LeoPezzini/nexo-midi-controller-Compl-Analog-II/docs/hardware/arquitectura.md

# Arquitectura del sistema

## Descripcion general

Nexo MIDI separa la adquisicion de controles, la interfaz, la persistencia y la
transmision MIDI mediante una maquina de estados. Los dieciseis controles
fisicos comparten la entrada analogica A0 mediante un CD74HC4067.

```mermaid
flowchart TD
    C[12 pulsadores y 4 potenciometros] --> M[CD74HC4067]
    M --> U[ATmega328P]
    E[Encoder] --> U
    U --> T[TFT ST7735 128x128]
    U <--> P[EEPROM]
    U --> D[MIDI OUT DIN]
    B[Bateria, TP4056 y MT3608] --> U
```

## Modos del firmware

- `PLAY`: transmite notas y mensajes CC.
- `MAIN_MENU`: acceso a presets, edicion y diagnostico de bateria.
- `PRESET_SELECT`: seleccion del preset activo.
- `PRESET_MANAGER`: crear, duplicar, restablecer o borrar.
- `PRESET_CONFIRM`: confirmacion de operaciones destructivas.
- `EDIT_GRID`: seleccion de potenciometro, pulsador, guardar o cancelar.
- `EDIT_DETAIL`: modificacion del mensaje y canal MIDI.

La edicion se realiza sobre una copia temporal. La opcion `X` descarta los
cambios y `V` los confirma y escribe en EEPROM.

## Datos persistentes

La EEPROM almacena una cabecera de identificacion, version del formato, preset
activo, mascara de presets existentes y ocho estructuras `Preset`. El primer
inicio habilita solamente el Preset 1. El sistema impide borrar el ultimo preset
existente.

## Flujo en modo PLAY

1. Se selecciona un canal del multiplexor.
2. Se descarta una primera conversion ADC despues de la conmutacion.
3. Los pulsadores pasan por antirrebote temporal.
4. Los potenciometros se filtran y cuantifican al intervalo MIDI 0-127.
5. Solo se transmite un CC cuando la variacion supera el umbral configurado.
6. La pantalla actualiza unicamente la region modificada para evitar parpadeo.

## Esquematico electrico

El esquema definitivo incluye el ATmega328P sobre la placa standalone, el
CD74HC4067, los doce pulsadores, los cuatro potenciometros, el encoder HW-040,
la TFT SPI, la salida MIDI DIN, la medicion de bateria y la cadena
TP4056-MT3608.

- [Esquematico en PDF](schematic/nexo-midi-schematic.pdf)
- [Proyecto editable de KiCad](schematic/nexo-midi.kicad_sch)
