LeoPezzini/nexo-midi-controller-Compl-Analog-II/docs/software/README.md

# Demostraciones de software

El objetivo de estas pruebas es demostrar que MIDI describe eventos y valores,
pero no impone una aplicacion concreta. El mismo hardware y el mismo firmware
pueden controlar musica, iluminacion o produccion audiovisual mediante
diferentes mapeos en el receptor.

| Aplicacion | Uso validado | Estado |
|---|---|---|
| QLC+ 5.2.2 | RGB, intensidad, escenas, apagado y secuencia | Validado |
| OBS Studio 32.2.2 | Escenas, grabacion, mute y niveles de audio | Validado |
| FL Studio | Bateria virtual, sintetizadores, parametros CC y grabacion | Validado |

Guias:

- [QLC+](qlc-plus.md)
- [OBS Studio](obs-studio.md)
- [FL Studio](fl-studio.md)

Las tres pruebas confirmaron que los mensajes de nota y Control Change pueden
adquirir funciones completamente diferentes sin modificar el hardware. El
controlador opero instrumentos musicales, iluminacion virtual y produccion
audiovisual mediante el mapeo realizado en cada aplicacion.
