LeoPezzini/nexo-midi-controller-Compl-Analog-II/CHANGELOG.md

# Historial de versiones

## v1.2.3

- Mapa del CD74HC4067 sincronizado con el cableado fisico definitivo.
- Pulsadores: C0-C11 segun la disposicion por columnas.
- Potenciometros: C12-C15 de izquierda a derecha.
- Esquematico electrico y polaridad de carga documentados.

## v1.2.2

- Nomenclatura de octavas alineada con FL Studio: MIDI 0 se muestra como C0 y
  MIDI 60 como C5.
- El cambio es exclusivamente visual; no modifica las notas almacenadas ni los
  mensajes MIDI transmitidos.

## v1.2.1

- Medicion de bateria mediante A1 y divisor 10k/10k.
- Indicador grafico de cuatro niveles.
- Aviso de bateria baja.
- Lectura numerica de tension en el menu.
- Correccion de desbordamiento en el calculo de milivoltios.

## v1.2

- Capacidad para ocho presets con solo uno habilitado inicialmente.
- Crear, duplicar, restablecer y borrar presets.
- Confirmacion antes de operaciones destructivas.
- Proteccion contra el borrado del ultimo preset.

## v1.1

- Modos PLAY y edicion.
- Notas, CC y canales configurables.
- Persistencia en EEPROM.
- Lectura estable del encoder, pulsadores y potenciometros.
