LeoPezzini/nexo-midi-controller-Compl-Analog-II/docs/hardware/schematic/nexo-midi-schematic.pdf

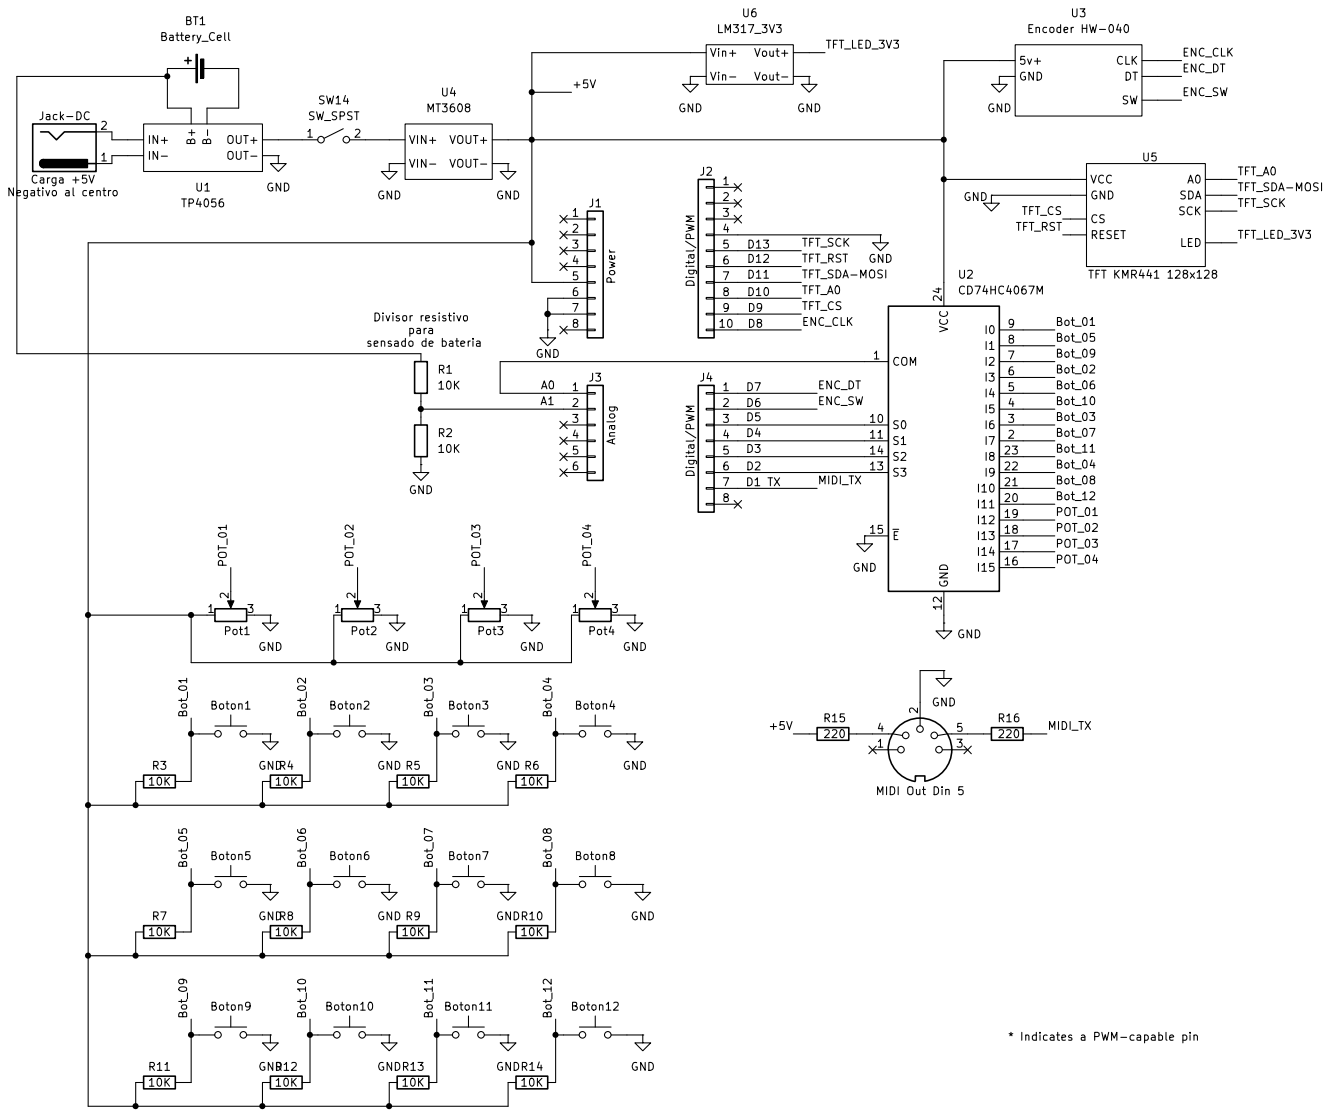
[picture p14: page 1]
