LeoPezzini/nexo-midi-controller-Compl-Analog-II/docs/hardware/schematic/nexo-midi.kicad_sch

## KiCad design docs/hardware/schematic/nexo-midi.kicad_sch (2026-11-05)

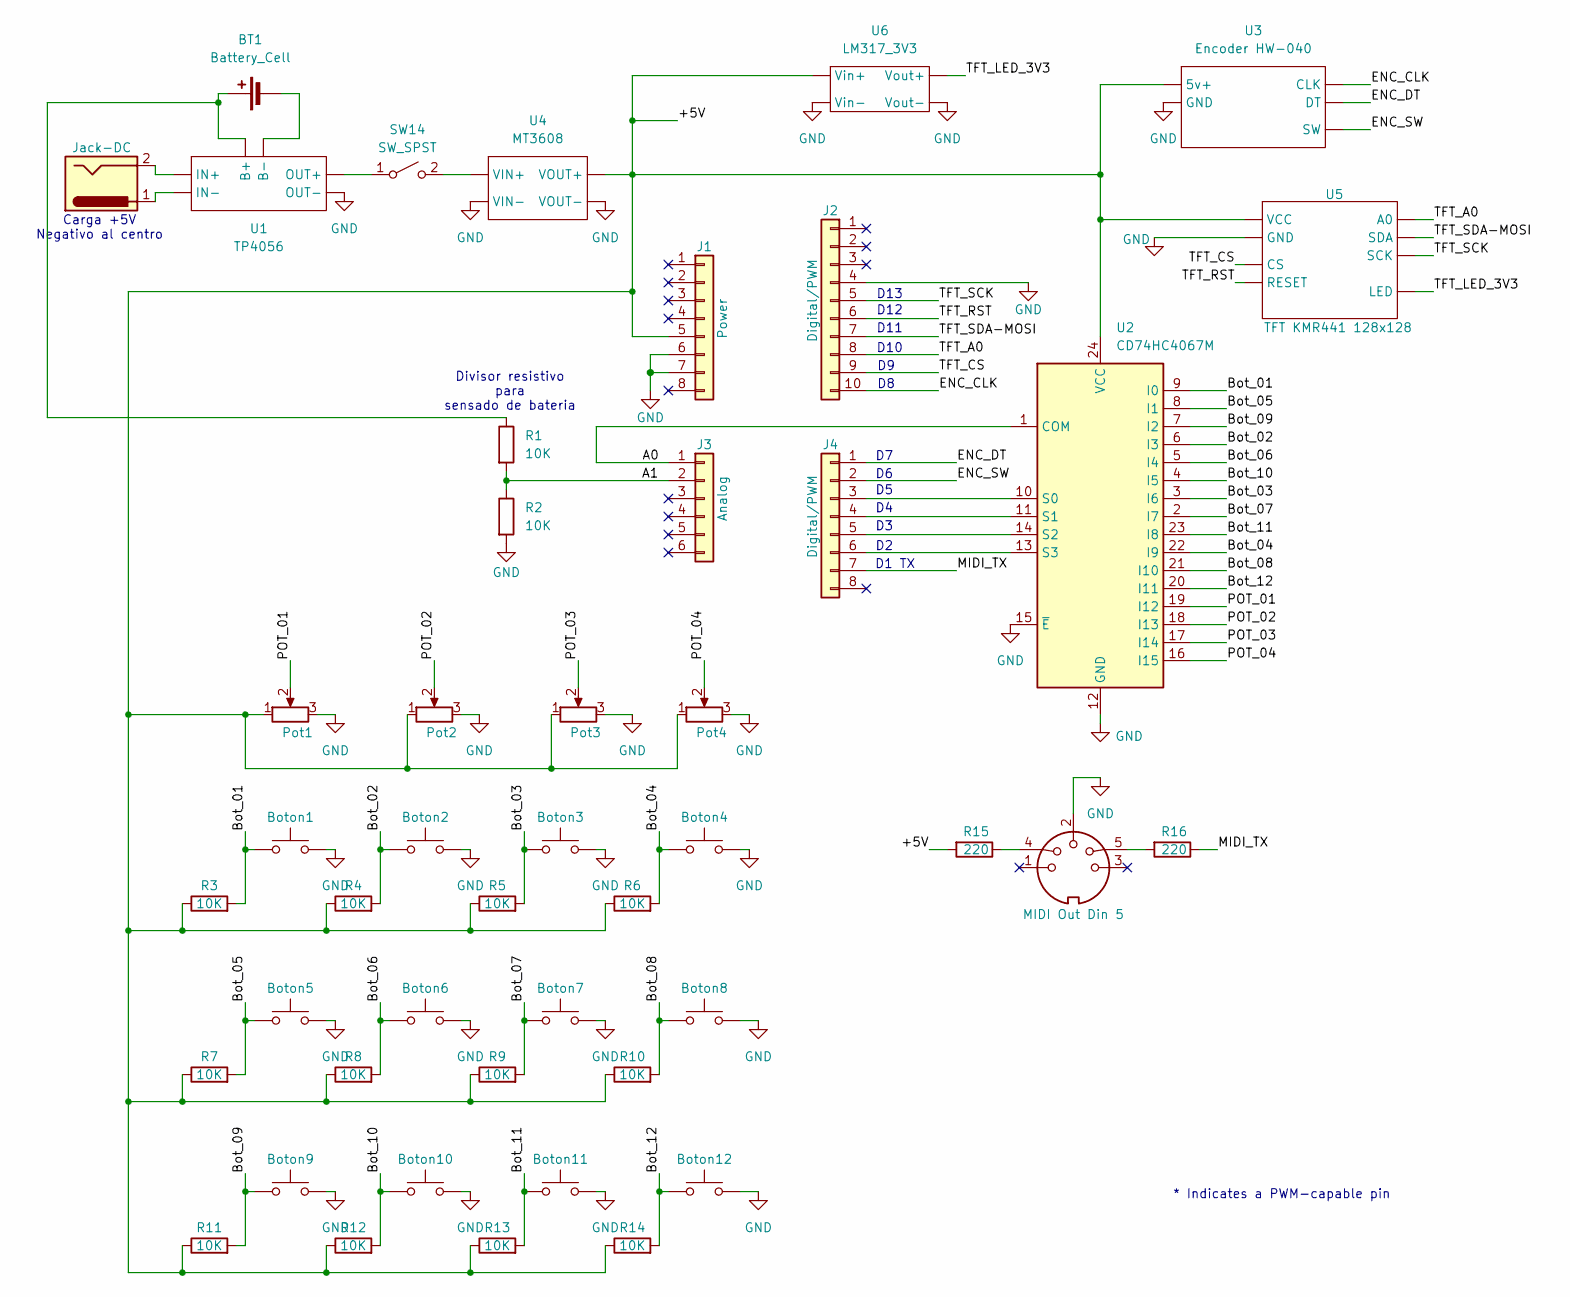
[picture p15: schematic nexo-midi.kicad_sch]

Parts:
BT1: Battery_Cell
Boton1, Boton2, Boton3, Boton4, Boton5, Boton6, Boton7, Boton8, Boton9, Boton10, Boton11, Boton12: SW_Push
J1: Power; PinSocket_1x08_P2.54mm_Vertical
J2: Digital/PWM; PinSocket_1x10_P2.54mm_Vertical
J3: Analog; PinSocket_1x06_P2.54mm_Vertical
J4: Digital/PWM; PinSocket_1x08_P2.54mm_Vertical
J5: Jack-DC
J6: MIDI Out Din 5
Pot1, Pot2, Pot3, Pot4: R_Potentiometer
R1, R2, R3, R4, R5, R6, R7, R8, R9, R10, R11, R12, R13, R14: 10K
R15, R16: 220
SW14: SW_SPST
U1: TP4056
U2: CD74HC4067M; SOIC-24W_7.5x15.4mm_P1.27mm
U3: Encoder HW-040
U4: MT3608
U5: TFT KMR441 128x128
U6: LM317_3V3

Connections:
+5V: J1.5, Pot1.1, Pot2.1, Pot3.1, Pot4.1, R3.1, R4.1, R5.1, R6.1, R7.1, R8.1, R9.1, R10.1, R11.1, R12.1, R13.1, R14.1, R15.2, U2.24 (VCC), U3.1 (5v+), U4.3 (VOUT+), U5.1 (VCC), U6.1 (Vin+)
A0: J3.1, U2.1 (COM)
A1: J3.2, R1.2, R2.1
Bot_01: Boton1.1, R3.2, U2.9 (I0)
Bot_02: Boton2.1, R4.2, U2.6 (I3)
Bot_03: Boton3.1, R5.2, U2.3 (I6)
Bot_04: Boton4.1, R6.2, U2.22 (I9)
Bot_05: Boton5.1, R7.2, U2.8 (I1)
Bot_06: Boton6.1, R8.2, U2.5 (I4)
Bot_07: Boton7.1, R9.2, U2.2 (I7)
Bot_08: Boton8.1, R10.2, U2.21 (I10)
Bot_09: Boton9.1, R11.2, U2.7 (I2)
Bot_10: Boton10.1, R12.2, U2.4 (I5)
Bot_11: Boton11.1, R13.2, U2.23 (I8)
Bot_12: Boton12.1, R14.2, U2.20 (I11)
ENC_CLK: J2.10, U3.3 (CLK)
ENC_DT: J4.1, U3.4 (DT)
ENC_SW: J4.2, U3.5 (SW)
GND: Boton1.2, Boton2.2, Boton3.2, Boton4.2, Boton5.2, Boton6.2, Boton7.2, Boton8.2, Boton9.2, Boton10.2, Boton11.2, Boton12.2, J1.6, J1.7, J2.4, J6.2, Pot1.3, Pot2.3, Pot3.3, Pot4.3, R2.2, U1.4 (OUT-), U2.12 (GND), U2.15 (~E), U3.2 (GND), U4.2 (VIN-), U4.4 (VOUT-), U5.2 (GND), U6.2 (Vin-), U6.4 (Vout-)
MIDI_TX: J4.7, R16.1
unnamed: BT1.1 (+), R1.1, U1.5 (B+)
unnamed: BT1.2 (-), U1.6 (B-)
unnamed: J4.3, U2.10 (S0)
unnamed: J4.4, U2.11 (S1)
unnamed: J4.5, U2.14 (S2)
unnamed: J4.6, U2.13 (S3)
unnamed: J5.1, U1.2 (IN-)
unnamed: J5.2, U1.1 (IN+)
unnamed: J6.4, R15.1
unnamed: J6.5, R16.2
unnamed: SW14.1 (A), U1.3 (OUT+)
unnamed: SW14.2 (B), U4.1 (VIN+)
POT_01: Pot1.2, U2.19 (I12)
POT_02: Pot2.2, U2.18 (I13)
POT_03: Pot3.2, U2.17 (I14)
POT_04: Pot4.2, U2.16 (I15)
TFT_A0: J2.8, U5.5 (A0)
TFT_CS: J2.9, U5.3 (CS)
TFT_LED_3V3: U5.8 (LED), U6.3 (Vout+)
TFT_RST: J2.6, U5.4 (RESET)
TFT_SCK: J2.5, U5.7 (SCK)
TFT_SDA-MOSI: J2.7, U5.6 (SDA)

Notes on the sheet:
Carga +5V Negativo al centro
D12
D1 TX
D10
* Indicates a PWM-capable pin
D11
Divisor resistivo para sensado de bateria
D13
