LeoPezzini/nexo-midi-controller-Compl-Analog-II/(commit log)

2026-09-24 docs: document battery power system
2026-09-24 chore: add Arduino gitignore
2026-10-17 Documentar validaciones de QLC+ y OBS Studio
2026-10-17 Ampliar validacion con aplicaciones de escritorio
2026-10-17 Actualizar estado de las demostraciones MIDI
2026-10-17 Alinear nomenclatura de octavas con FL Studio
2026-11-05 Actualizar esquematico KiCad y PDF con nueva revision
